EquasysIT/ElectronULA/Kicad/README.md

The Core Carrier board is a board which requires the "EEpizza" board to be fitted. This is a board which actually contains the FPGA.
The MAX 10 Board is a complete board with everything required to replace the Acorn Electron ULA on a single board.

V1.05 is the latest board design including a Micro SD Card socket and enables the use of MMFS for people without the extra Plus 1 hardware.
Ensure the DIP switches are set correctly if connecting a Plus 1
