EquasysIT/ElectronULA/(threads)

Thread 2 (2023-03-30):

Unreliability

EquasysIT, 2023-03-30:
I came across issues when testing the board in an issue 2 Electron. This manifested itself as crashing and general unreliable behaviour. I first thought this was down to noise on the IRQ line which was causing the unwanted interrupts. After much digging into this it transpired that it was NMI interrupts that were occurring due to me forgetting to include a pull up resistor for the NMI pin which was floating. After adding a pull-up resistor this massively improved things although some unreliability was still present. The fix for this was to clock the flash memory which is being used for ROM at 96mhz.

EquasysIT, 2023-05-09:
A further level of unreliable behavior was found to occur with MMFS file access and more specifically JAVA mode 7. MMFS would occasionally fail to access the SD card reliably especially when switching the external 6502 for a different version. Also JAVA mode 7 would keep blanking out especially if the cpu clk timing was altered slightly which shouldn't have caused this effect. After many many hours of testing and working on this issue it was found to be noise transferring from the ROM_n signal which feeds the external ROM. The solution was to drive ROM_n direct from the FPGA and not via the 74HCT125 buffer which has very fast edges. This reduced the noise and all the problems went away !!
