EquasysIT/ElectronULA/Kicad/ElectronULA - MAX 10 Board V1.05/ElectronULA.kicad_pcb

## KiCad design Kicad/ElectronULA - MAX 10 Board V1.05/ElectronULA.kicad_pcb (2023-07-15)

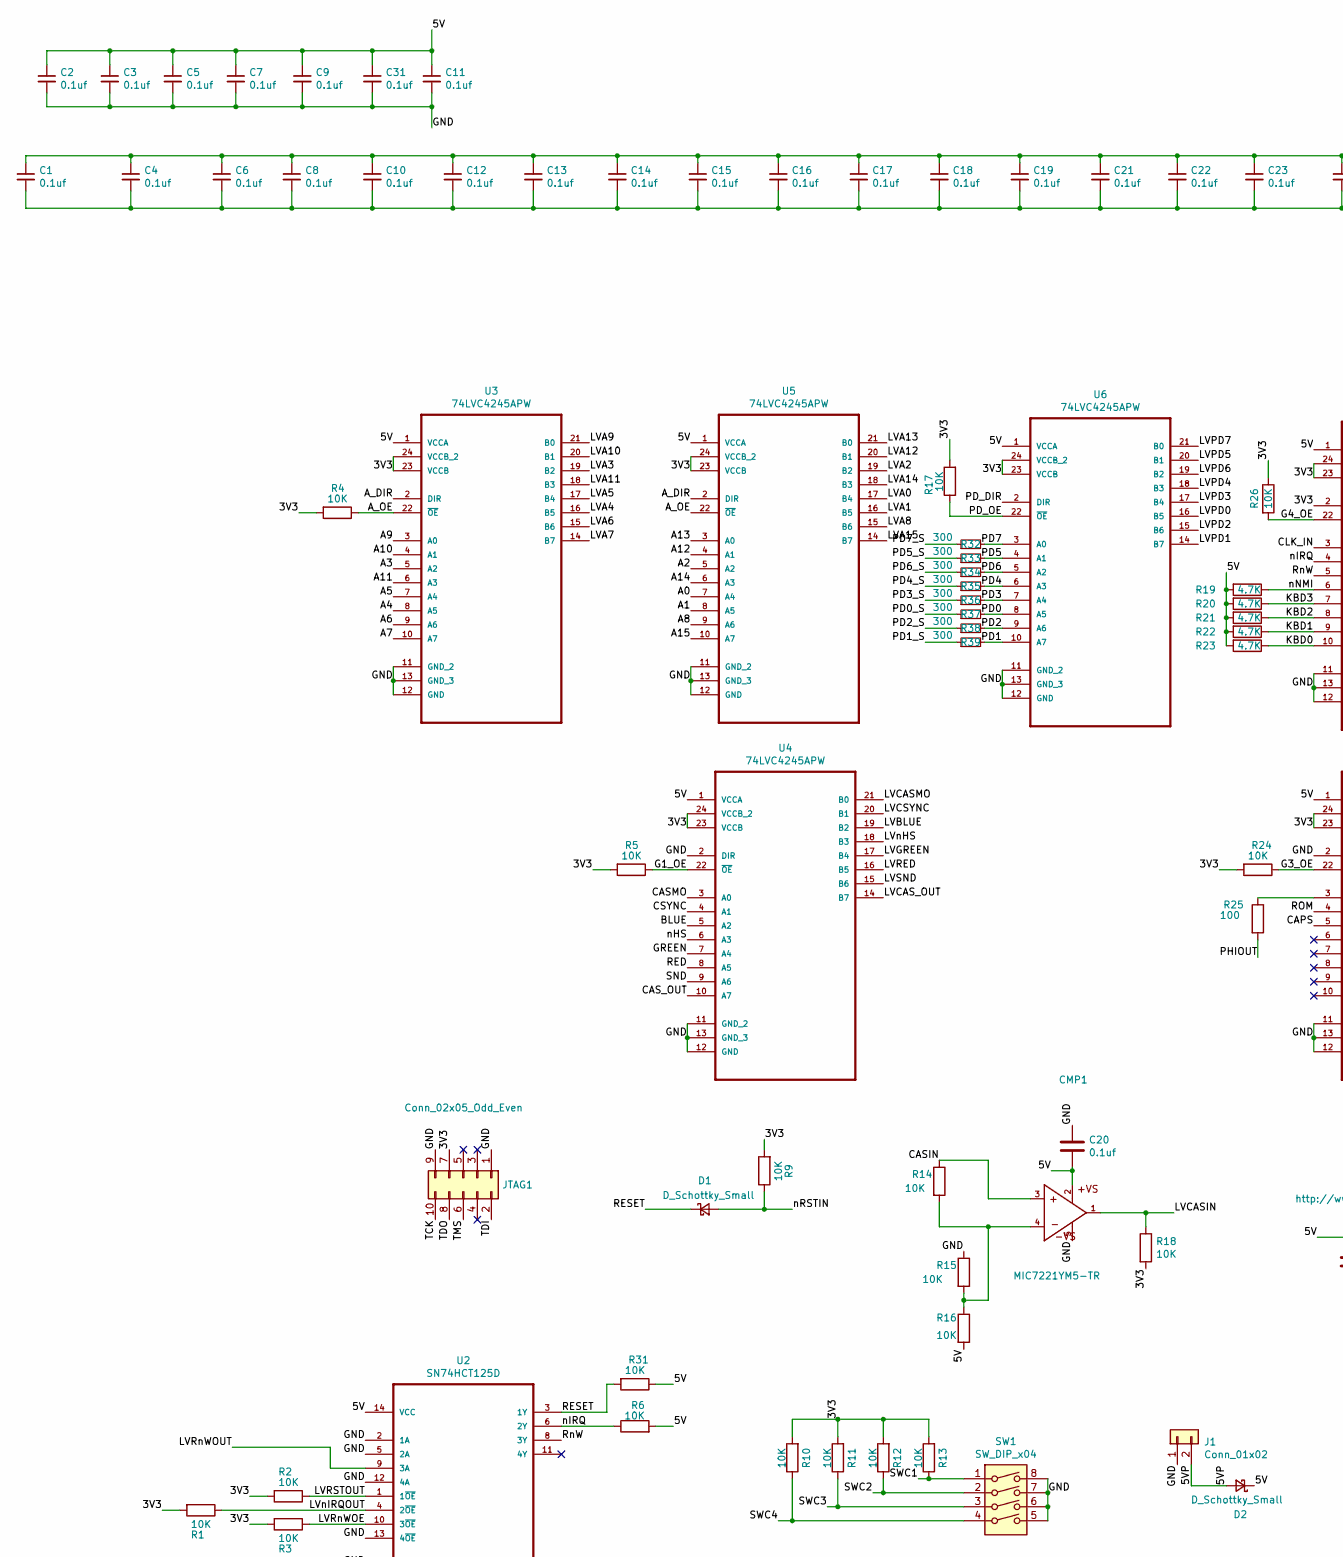
[picture p1: schematic ElectronULA.kicad_sch, part in row 1, column 1]

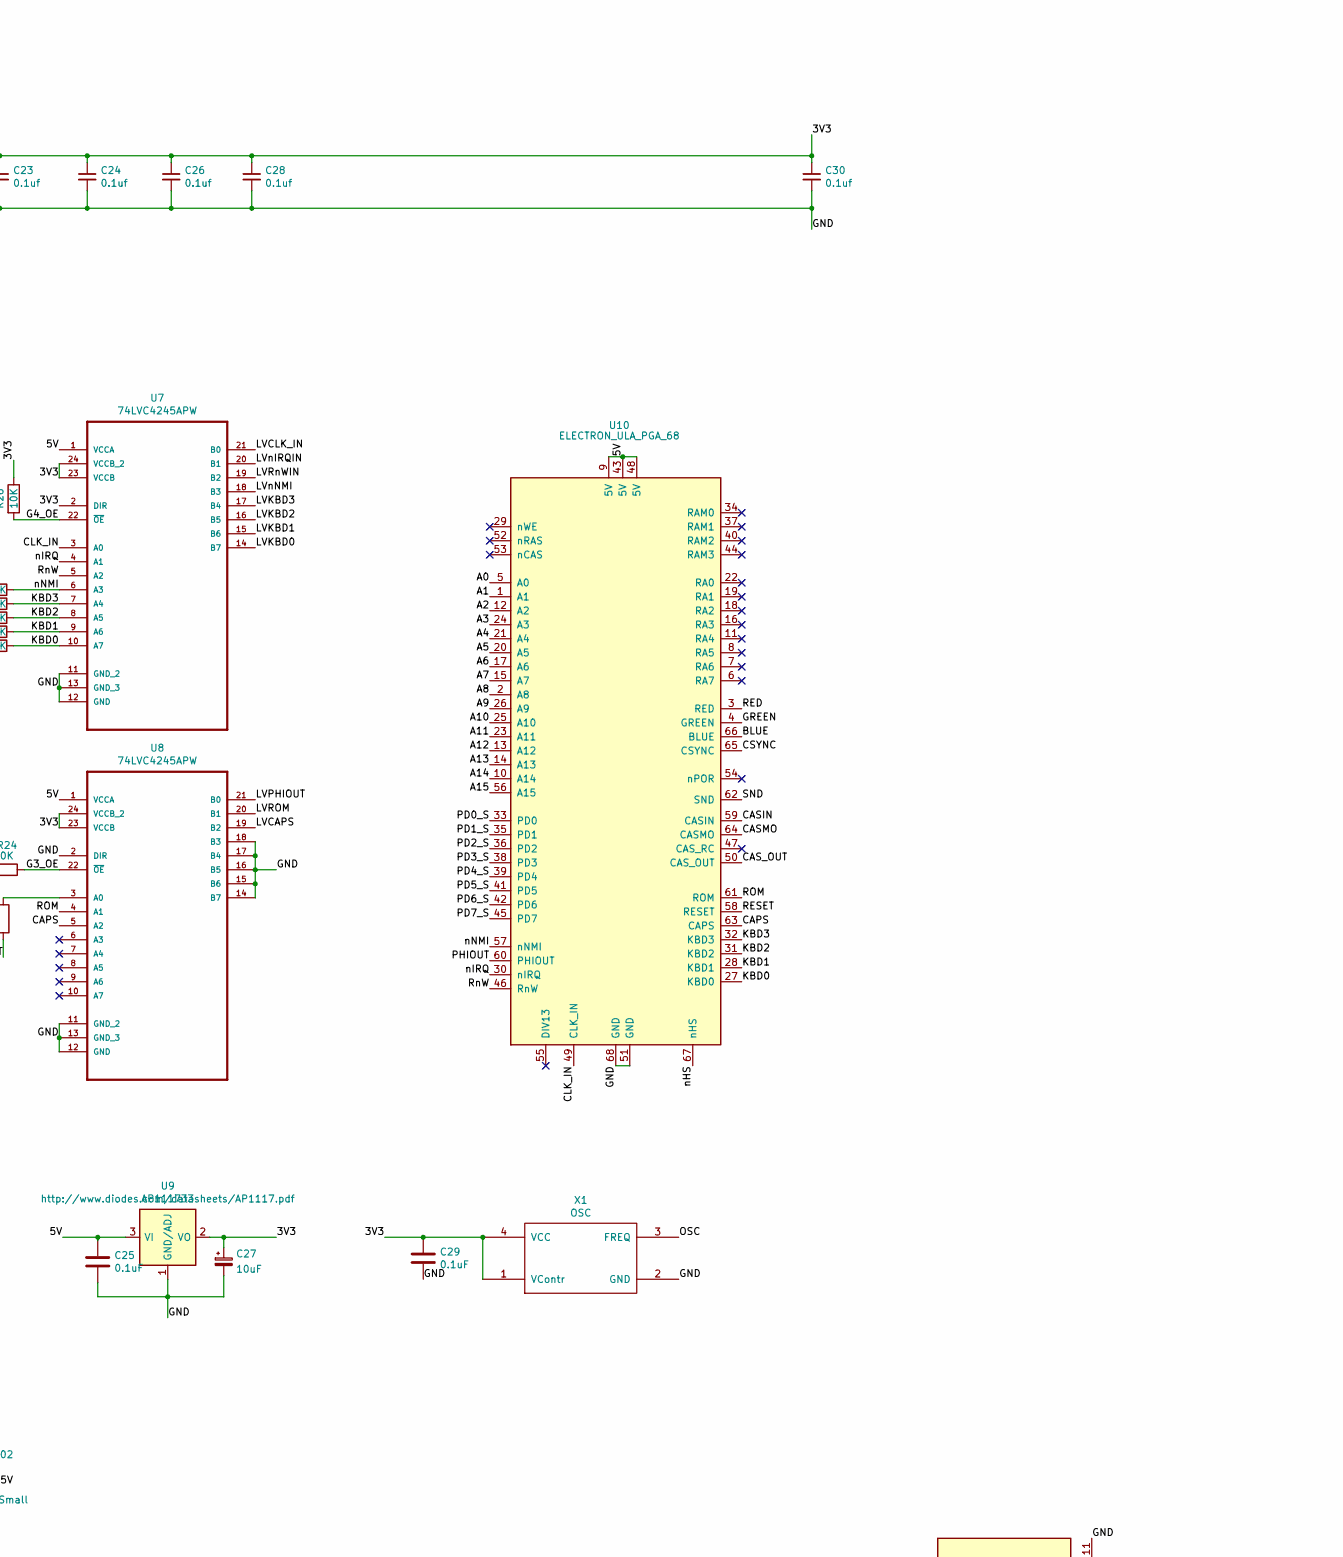
[picture p2: schematic ElectronULA.kicad_sch, part in row 1, column 2]

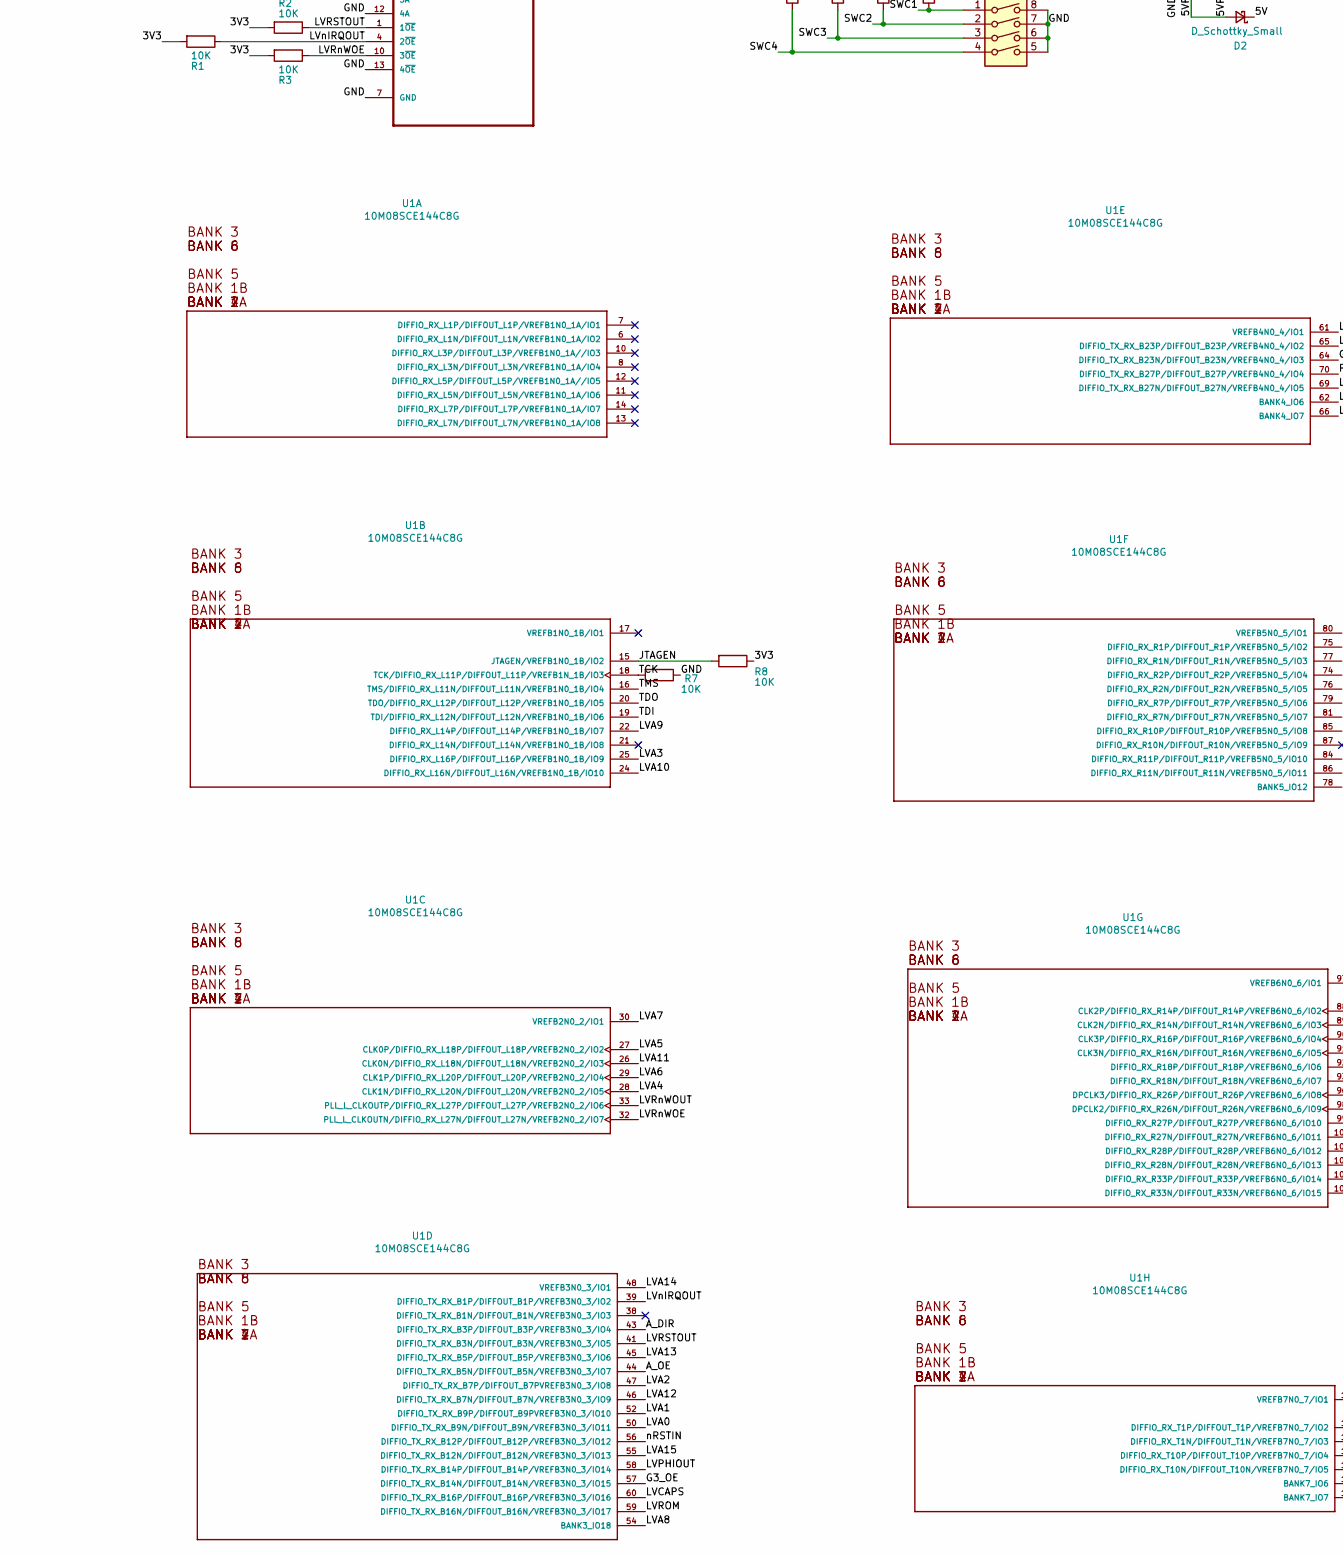
[picture p3: schematic ElectronULA.kicad_sch, part in row 2, column 1]

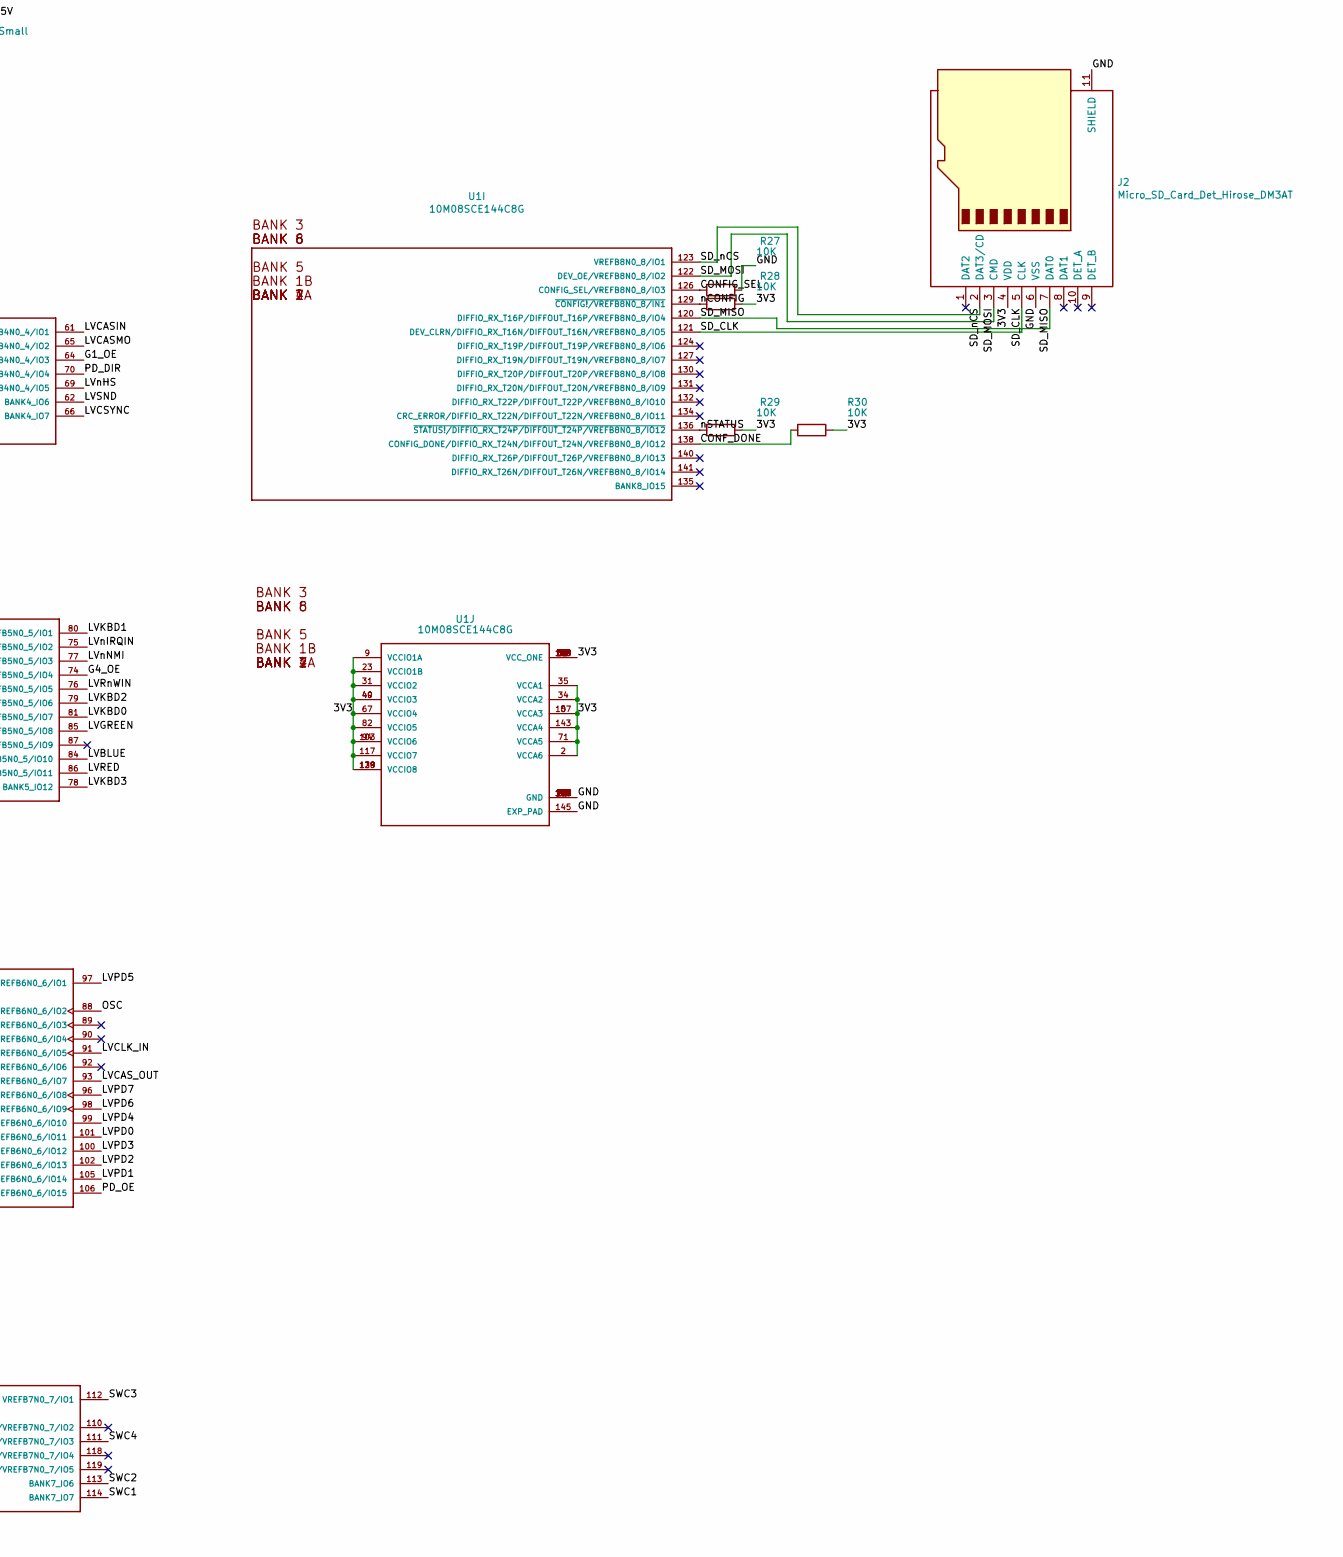
[picture p4: schematic ElectronULA.kicad_sch, part in row 2, column 2]

Parts:
C1, C2, C3, C4, C5, C6, C7, C8, C9, C10, C11, C12, C13, C14, C15, C16, C17, C18, C19, C21, C22, C23, C24, C26, C28, C30, C31: 0.1uf; C_0603_1608Metric_Pad1.08x0.95mm_HandSolder
C20: 0.1uf; C_0805_2012Metric_Pad1.18x1.45mm_HandSolder
C25, C29: 0.1uF; C_0805_2012Metric_Pad1.18x1.45mm_HandSolder
C27: 10uF; C_0805_2012Metric_Pad1.18x1.45mm_HandSolder
CMP1: MIC7221YM5-TR; SOT-23-5
D1, D2: D_Schottky_Small; D_SOD-323_HandSoldering
J1: Conn_01x02; PinHeader_1x02_P2.54mm_Vertical
J2: Micro_SD_Card_Det_Hirose_DM3AT; microSD_HC_Hirose_DM3D-SF
JTAG1: Conn_02x05_Odd_Even; PinHeader_2x05_P2.54mm_Vertical
R1, R2, R3, R4, R5, R6, R7, R8, R10, R11, R12, R13, R17, R24, R26, R27, R28, R29, R30: 10K; R_0603_1608Metric_Pad0.98x0.95mm_HandSolder
R9, R14, R15, R16, R18, R31: 10K; R_0805_2012Metric_Pad1.20x1.40mm_HandSolder
R19: 4.7K; R_0805_2012Metric_Pad1.20x1.40mm_HandSolder
R20, R21, R22, R23: 4.7K; R_0603_1608Metric_Pad0.98x0.95mm_HandSolder
R25: 100; R_0805_2012Metric_Pad1.20x1.40mm_HandSolder
R32, R33, R34, R35, R36, R37, R38, R39: 300; R_0603_1608Metric_Pad0.98x0.95mm_HandSolder
SW1: SW_DIP_x04; SW_DIP_SPSTx04_Slide_Copal_CHS-04B_W7.62mm_P1.27mm
U1: 10M08SCE144C8G; QFP50P2200X2200X165-145N
U2: SN74HCT125D; TSSOP-14_4.4x5mm_P0.65mm
U3, U4, U5, U6, U7, U8: 74LVC4245APW; TSSOP-24_4.4x7.8mm_P0.65mm
U9: AP111733; SOT-223
U10: ELECTRON_ULA_PGA_68; PLCC-68_THT-Socket-Electron-ULA
X1: OSC; Crystal_SMD_7050_4Pads

Connections:
/3V3: C1.1, C4.1, C6.1, C8.1, C10.1, C12.1, C13.1, C14.1, C15.1, C16.1, C17.1, C18.1, C19.1, C21.1, C22.1, C23.1, C24.1, C26.1, C27.1, C28.1, C29.1, C30.1, J2.4 (VDD), JTAG1.7, R1.2, R2.2, R3.2, R4.2, R5.2, R8.1, R9.2, R10.2, R11.2, R12.2, R13.2, R17.2, R18.2, R24.2, R26.1, R28.1, R29.1, R30.1, U1.1 (VCC_ONE), U1.2 (VCCA6), U1.5 (VCCA3), U1.9 (VCCIO1A), U1.23 (VCCIO1B), U1.31 (VCCIO2), U1.34 (VCCA2), U1.35 (VCCA1), U1.36 (VCC_ONE), U1.37 (VCC_ONE), U1.40 (VCCIO3), U1.49 (VCCIO3), U1.51 (VCC_ONE), U1.67 (VCCIO4), U1.71 (VCCA5), U1.72 (VCC_ONE), U1.73 (VCC_ONE), U1.82 (VCCIO5), U1.94 (VCCIO6), U1.103 (VCCIO6), U1.107 (VCCA3), U1.108 (VCC_ONE), U1.109 (VCC_ONE), U1.115 (VCC_ONE), U1.117 (VCCIO7), U1.128 (VCCIO8), U1.139 (VCCIO8), U1.143 (VCCA4), U1.144 (VCC_ONE), U3.23 (VCCB), U3.24 (VCCB_2), U4.23 (VCCB), U4.24 (VCCB_2), U5.23 (VCCB), U5.24 (VCCB_2), U6.23 (VCCB), U6.24 (VCCB_2), U7.2 (DIR), U7.23 (VCCB), U7.24 (VCCB_2), U8.23 (VCCB), U8.24 (VCCB_2), U9.2 (VO), X1.1 (VContr), X1.4 (VCC)
/5V: C2.1, C3.1, C5.1, C7.1, C9.1, C11.1, C20.2, C25.1, C31.1, CMP1.2 (+VS), D2.1 (K), R6.2, R16.2, R19.2, R20.2, R21.2, R22.2, R23.2, R31.1, U2.14 (VCC), U3.1 (VCCA), U4.1 (VCCA), U5.1 (VCCA), U6.1 (VCCA), U7.1 (VCCA), U8.1 (VCCA), U9.3 (VI), U10.9 (5V), U10.43 (5V), U10.48 (5V)
/5VP: D2.2 (A), J1.2
/A0: U5.7 (A4), U10.5 (A0)
/A1: U5.8 (A5), U10.1 (A1)
/A2: U5.5 (A2), U10.12 (A2)
/A3: U3.5 (A2), U10.24 (A3)
/A4: U3.8 (A5), U10.21 (A4)
/A5: U3.7 (A4), U10.20 (A5)
/A6: U3.9 (A6), U10.17 (A6)
/A7: U3.10 (A7), U10.15 (A7)
/A8: U5.9 (A6), U10.2 (A8)
/A9: U3.3 (A0), U10.26 (A9)
/A10: U3.4 (A1), U10.25 (A10)
/A11: U3.6 (A3), U10.23 (A11)
/A12: U5.4 (A1), U10.13 (A12)
/A13: U5.3 (A0), U10.14 (A13)
/A14: U5.6 (A3), U10.10 (A14)
/A15: U5.10 (A7), U10.56 (A15)
/A_DIR: U1.43 (DIFFIO_TX_RX_B3P/DIFFOUT_B3P/VREFB3N0_3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), U3.2 (DIR), U5.2 (DIR)
/A_OE: R4.1, U1.44 (DIFFIO_TX_RX_B5N/DIFFOUT_B5N/VREFB3N0_3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), U3.22 (~OE), U5.22 (~OE)
/BLUE: U4.5 (A2), U10.66 (BLUE)
/CAPS: U8.5 (A2), U10.63 (CAPS)
/CASIN: CMP1.3 (IN+), R14.1, U10.59 (CASIN)
/CASMO: U4.3 (A0), U10.64 (CASMO)
/CAS_OUT: U4.10 (A7), U10.50 (CAS_OUT)
/CLK_IN: U7.3 (A0), U10.49 (CLK_IN)
/CONFIG_SEL: R27.2, U1.126 (CONFIG_SEL/VREFB8N0_8/IO3)
/CONF_DONE: R30.2, U1.138 (CONFIG_DONE/DIFFIO_RX_T24N/DIFFOUT_T24N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)
/CSYNC: U4.4 (A1), U10.65 (CSYNC)
/G1_OE: R5.1, U1.64 (DIFFIO_TX_RX_B23N/DIFFOUT_B23N/VREFB4N0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), U4.22 (~OE)
/G3_OE: R24.1, U1.57 (DIFFIO_TX_RX_B14N/DIFFOUT_B14N/VREFB3N0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), U8.22 (~OE)
/G4_OE: R26.2, U1.74 (DIFFIO_RX_R2P/DIFFOUT_R2P/VREFB5N0_5/IO4), U7.22 (~OE)
/GND: C1.2, C2.2, C3.2, C4.2, C5.2, C6.2, C7.2, C8.2, C9.2, C10.2, C11.2, C12.2, C13.2, C14.2, C15.2, C16.2, C17.2, C18.2, C19.2, C20.1, C21.2, C22.2, C23.2, C24.2, C25.2, C26.2, C27.2, C28.2, C29.2, C30.2, C31.2, CMP1.5 (-VS), J1.1, J2.6 (VSS), J2.11 (SHIELD), JTAG1.1, JTAG1.9, R7.1, R15.1, R27.1, SW1.5, SW1.6, SW1.7, SW1.8, U1.3 (GND), U1.4 (GND), U1.42 (GND), U1.53 (GND), U1.63 (GND), U1.68 (GND), U1.83 (GND), U1.95 (GND), U1.104 (GND), U1.116 (GND), U1.125 (GND), U1.133 (GND), U1.137 (GND), U1.142 (GND), U1.145 (EXP_PAD), U2.2 (1A), U2.5 (2A), U2.7 (GND), U2.12 (4A), U2.13 (4~OE), U3.11 (GND_2), U3.12 (GND), U3.13 (GND_3), U4.2 (DIR), U4.11 (GND_2), U4.12 (GND), U4.13 (GND_3), U5.11 (GND_2), U5.12 (GND), U5.13 (GND_3), U6.11 (GND_2), U6.12 (GND), U6.13 (GND_3), U7.11 (GND_2), U7.12 (GND), U7.13 (GND_3), U8.2 (DIR), U8.11 (GND_2), U8.12 (GND), U8.13 (GND_3), U8.14 (B7), U8.15 (B6), U8.16 (B5), U8.17 (B4), U8.18 (B3), U9.1 (GND/ADJ), U10.51 (GND), U10.68 (GND), X1.2 (GND); also elsewhere on the board
/GREEN: U4.7 (A4), U10.4 (GREEN)
/JTAGEN: R8.2, U1.15 (JTAGEN/VREFB1N0_1B/IO2)
/KBD0: R23.1, U7.10 (A7), U10.27 (KBD0)
/KBD1: R22.1, U7.9 (A6), U10.28 (KBD1)
/KBD2: R21.1, U7.8 (A5), U10.31 (KBD2)
/KBD3: R20.1, U7.7 (A4), U10.32 (KBD3)
/LVA0: U1.50 (DIFFIO_TX_RX_B9N/DIFFOUT_B9N/VREFB3N0_3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), U5.17 (B4)
/LVA1: U1.52 (DIFFIO_TX_RX_B9P/DIFFOUT_B9PVREFB3N0_3/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), U5.16 (B5)
/LVA2: U1.47 (DIFFIO_TX_RX_B7P/DIFFOUT_B7PVREFB3N0_3/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), U5.19 (B2)
/LVA3: U1.25 (DIFFIO_RX_L16P/DIFFOUT_L16P/VREFB1N0_1B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), U3.19 (B2)
/LVA4: U1.28 (CLK1N/DIFFIO_RX_L20N/DIFFOUT_L20N/VREFB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), U3.16 (B5)
/LVA5: U1.27 (CLK0P/DIFFIO_RX_L18P/DIFFOUT_L18P/VREFB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), U3.17 (B4)
/LVA6: U1.29 (CLK1P/DIFFIO_RX_L20P/DIFFOUT_L20P/VREFB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), U3.15 (B6)
/LVA7: U1.30 (VREFB2N0_2/IO1), U3.14 (B7)
/LVA8: U1.54 (BANK3_IO18), U5.15 (B6)
/LVA9: U1.22 (DIFFIO_RX_L14P/DIFFOUT_L14P/VREFB1N0_1B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), U3.21 (B0)
/LVA10: U1.24 (DIFFIO_RX_L16N/DIFFOUT_L16N/VREFB1N0_1B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), U3.20 (B1)
/LVA11: U1.26 (CLK0N/DIFFIO_RX_L18N/DIFFOUT_L18N/VREFB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), U3.18 (B3)
/LVA12: U1.46 (DIFFIO_TX_RX_B7N/DIFFOUT_B7N/VREFB3N0_3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), U5.20 (B1)
/LVA13: U1.45 (DIFFIO_TX_RX_B5P/DIFFOUT_B5P/VREFB3N0_3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), U5.21 (B0)
/LVA14: U1.48 (VREFB3N0_3/IO1), U5.18 (B3)
/LVA15: U1.55 (DIFFIO_TX_RX_B12N/DIFFOUT_B12N/VREFB3N0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), U5.14 (B7)
/LVBLUE: U1.84 (DIFFIO_RX_R11P/DIFFOUT_R11P/VREFB5N0_5/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), U4.19 (B2)
/LVCAPS: U1.60 (DIFFIO_TX_RX_B16P/DIFFOUT_B16P/VREFB3N0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), U8.19 (B2)
/LVCASIN: CMP1.1 (OUT), R18.1, U1.61 (VREFB4N0_4/IO1)
/LVCASMO: U1.65 (DIFFIO_TX_RX_B23P/DIFFOUT_B23P/VREFB4N0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), U4.21 (B0)
/LVCAS_OUT: U1.93 (DIFFIO_RX_R18N/DIFFOUT_R18N/VREFB6N0_6/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), U4.14 (B7)
/LVCLK_IN: U1.91 (CLK3N/DIFFIO_RX_R16N/DIFFOUT_R16N/VREFB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), U7.21 (B0)
/LVCSYNC: U1.66 (BANK4_IO7), U4.20 (B1)
/LVGREEN: U1.85 (DIFFIO_RX_R10P/DIFFOUT_R10P/VREFB5N0_5/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), U4.17 (B4)
/LVKBD0: U1.81 (DIFFIO_RX_R7N/DIFFOUT_R7N/VREFB5N0_5/IO7), U7.14 (B7)
/LVKBD1: U1.80 (VREFB5N0_5/IO1), U7.15 (B6)
/LVKBD2: U1.79 (DIFFIO_RX_R7P/DIFFOUT_R7P/VREFB5N0_5/IO6), U7.16 (B5)
/LVKBD3: U1.78 (BANK5_IO12), U7.17 (B4)
/LVPD0: U1.101 (DIFFIO_RX_R27N/DIFFOUT_R27N/VREFB6N0_6/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), U6.16 (B5)
/LVPD1: U1.105 (DIFFIO_RX_R33P/DIFFOUT_R33P/VREFB6N0_6/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), U6.14 (B7)
/LVPD2: U1.102 (DIFFIO_RX_R28N/DIFFOUT_R28N/VREFB6N0_6/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), U6.15 (B6)
/LVPD3: U1.100 (DIFFIO_RX_R28P/DIFFOUT_R28P/VREFB6N0_6/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), U6.17 (B4)
/LVPD4: U1.99 (DIFFIO_RX_R27P/DIFFOUT_R27P/VREFB6N0_6/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), U6.18 (B3)
/LVPD5: U1.97 (VREFB6N0_6/IO1), U6.20 (B1)
/LVPD6: U1.98 (DPCLK2/DIFFIO_RX_R26N/DIFFOUT_R26N/VREF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), U6.19 (B2)
/LVPD7: U1.96 (DPCLK3/DIFFIO_RX_R26P/DIFFOUT_R26P/VREF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), U6.21 (B0)
/LVPHIOUT: U1.58 (DIFFIO_TX_RX_B14P/DIFFOUT_B14P/VREFB3N0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), U8.21 (B0)
/LVRED: U1.86 (DIFFIO_RX_R11N/DIFFOUT_R11N/VREFB5N0_5/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), U4.16 (B5)
/LVROM: U1.59 (DIFFIO_TX_RX_B16N/DIFFOUT_B16N/VREFB3N0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), U8.20 (B1)
/LVRSTOUT: R2.1, U1.41 (DIFFIO_TX_RX_B3N/DIFFOUT_B3N/VREFB3N0_3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), U2.1 (1~OE)
/LVRnWIN: U1.76 (DIFFIO_RX_R2N/DIFFOUT_R2N/VREFB5N0_5/IO5), U7.19 (B2)
/LVRnWOE: R3.1, U1.32 (PLL_L_CLKOUTN/DIFFIO_RX_L27N/DIFFOUT_L2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), U2.10 (3~OE)
/LVRnWOUT: U1.33 (PLL_L_CLKOUTP/DIFFIO_RX_L27P/DIFFOUT_L2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), U2.9 (3A)
/LVSND: U1.62 (BANK4_IO6), U4.15 (B6)
/LVnHS: U1.69 (DIFFIO_TX_RX_B27N/DIFFOUT_B27N/VREFB4N0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), U4.18 (B3)
/LVnIRQIN: U1.75 (DIFFIO_RX_R1P/DIFFOUT_R1P/VREFB5N0_5/IO2), U7.20 (B1)
/LVnIRQOUT: R1.1, U1.39 (DIFFIO_TX_RX_B1P/DIFFOUT_B1P/VREFB3N0_3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), U2.4 (2~OE)
/LVnNMI: U1.77 (DIFFIO_RX_R1N/DIFFOUT_R1N/VREFB5N0_5/IO3), U7.18 (B3)
/OSC: U1.88 (CLK2P/DIFFIO_RX_R14P/DIFFOUT_R14P/VREFB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), X1.3 (FREQ)
/PD0: R37.2, U6.8 (A5)
/PD0_S: R37.1, U10.33 (PD0)
/PD1: R39.2, U6.10 (A7)
/PD1_S: R39.1, U10.35 (PD1)
/PD2: R38.2, U6.9 (A6)
/PD2_S: R38.1, U10.36 (PD2)
/PD3: R36.2, U6.7 (A4)
/PD3_S: R36.1, U10.38 (PD3)
/PD4: R35.2, U6.6 (A3)
/PD4_S: R35.1, U10.39 (PD4)
/PD5: R33.2, U6.4 (A1)
/PD5_S: R33.1, U10.41 (PD5)
/PD6: R34.2, U6.5 (A2)
/PD6_S: R34.1, U10.42 (PD6)
/PD7: R32.2, U6.3 (A0)
/PD7_S: R32.1, U10.45 (PD7)
/PD_DIR: U1.70 (DIFFIO_TX_RX_B27P/DIFFOUT_B27P/VREFB4N0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), U6.2 (DIR)
/PD_OE: R17.1, U1.106 (DIFFIO_RX_R33N/DIFFOUT_R33N/VREFB6N0_6/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), U6.22 (~OE)
/PHIOUT: R25.2, U10.60 (PHIOUT)
/RED: U4.8 (A5), U10.3 (RED)
/RESET: D1.1 (K), R31.2, U2.3 (1Y), U10.58 (RESET)
/ROM: U8.4 (A1), U10.61 (ROM)
/RnW: U2.8 (3Y), U7.5 (A2), U10.46 (RnW)
/SD_CLK: J2.5 (CLK), U1.121 (DEV_CLRN/DIFFIO_RX_T16N/DIFFOUT_T16N/VR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)
/SD_MISO: J2.7 (DAT0), U1.120 (DIFFIO_RX_T16P/DIFFOUT_T16P/VREFB8N0_8/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)
/SD_MOSI: J2.3 (CMD), U1.122 (DEV_OE/VREFB8N0_8/IO2)
/SD_nCS: J2.2 (DAT3/CD), U1.123 (VREFB8N0_8/IO1)
/SND: U4.9 (A6), U10.62 (SND)
/SWC1: R13.1, SW1.1, U1.114 (BANK7_IO7)
/SWC2: R12.1, SW1.2, U1.113 (BANK7_IO6)
/SWC3: R11.1, SW1.3, U1.112 (VREFB7N0_7/IO1)
/SWC4: R10.1, SW1.4, U1.111 (DIFFIO_RX_T1N/DIFFOUT_T1N/VREFB7N0_7/IO3)
/TCK: JTAG1.10, R7.2, U1.18 (TCK/DIFFIO_RX_L11P/DIFFOUT_L11P/VREFB1N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)
/TDI: JTAG1.2, U1.19 (TDI/DIFFIO_RX_L12N/DIFFOUT_L12N/VREFB1N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)
/TDO: JTAG1.8, U1.20 (TDO/DIFFIO_RX_L12P/DIFFOUT_L12P/VREFB1N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)
/TMS: JTAG1.6, U1.16 (TMS/DIFFIO_RX_L11N/DIFFOUT_L11N/VREFB1N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)
/nCONFIG: R28.2, U1.129 (~CONFIG!/VREFB8N0_8/IN1)
/nHS: U4.6 (A3), U10.67 (nHS)
/nIRQ: R6.1, U2.6 (2Y), U7.4 (A1), U10.30 (nIRQ)
/nNMI: R19.1, U7.6 (A3), U10.57 (nNMI)
/nRSTIN: D1.2 (A), R9.1, U1.56 (DIFFIO_TX_RX_B12P/DIFFOUT_B12P/VREFB3N0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)
/nSTATUS: R29.2, U1.136 (~STATUS!/DIFFIO_RX_T24P/DIFFOUT_T24P/VR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)
unnamed: CMP1.4 (IN-), R14.2, R15.2, R16.1
unnamed: R25.1, U8.3 (A0)

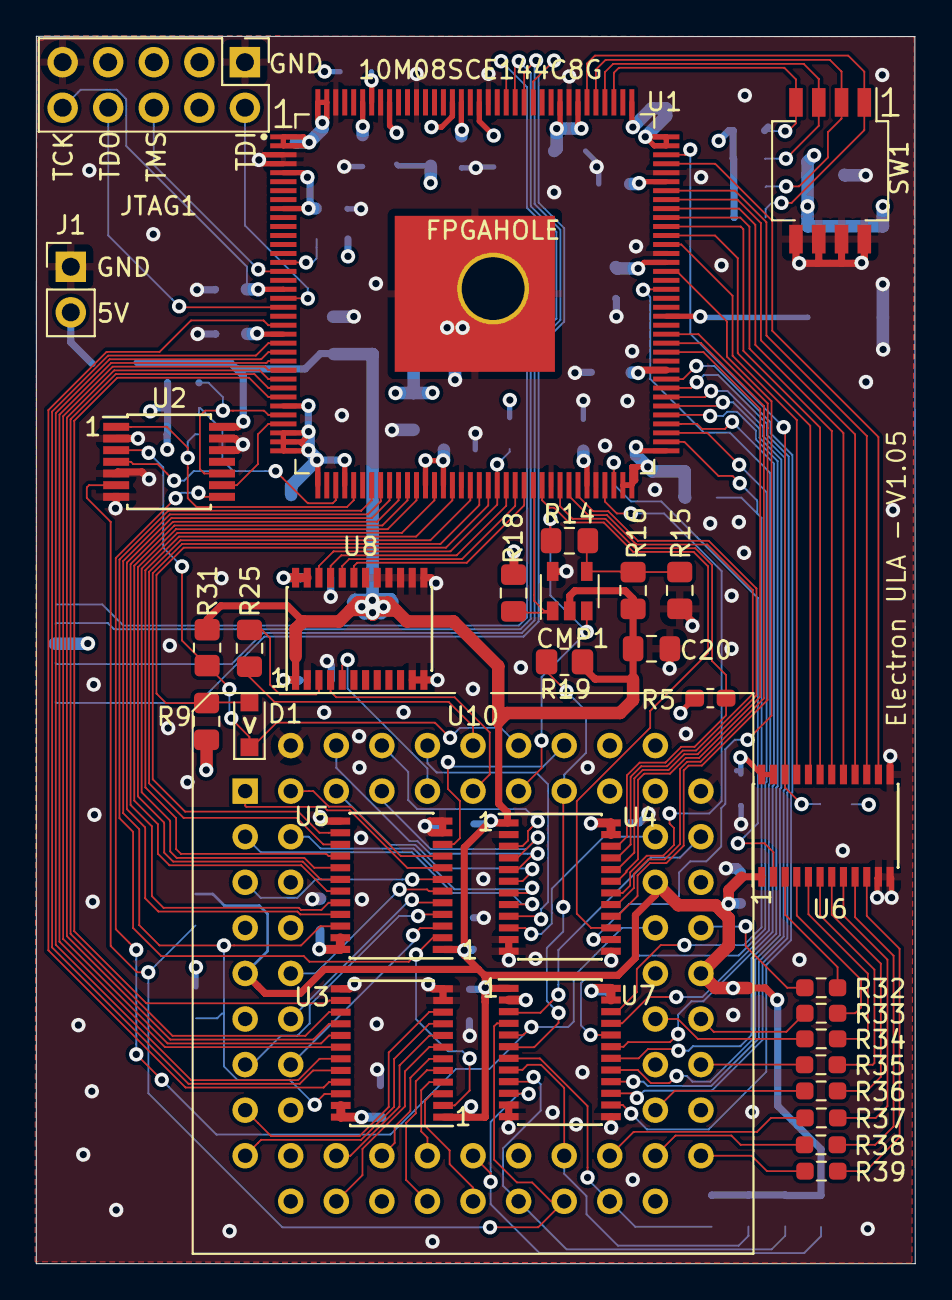
[picture p5: board Kicad/ElectronULA - MAX 10 Board V1.05/ElectronULA.kicad_pcb from above]

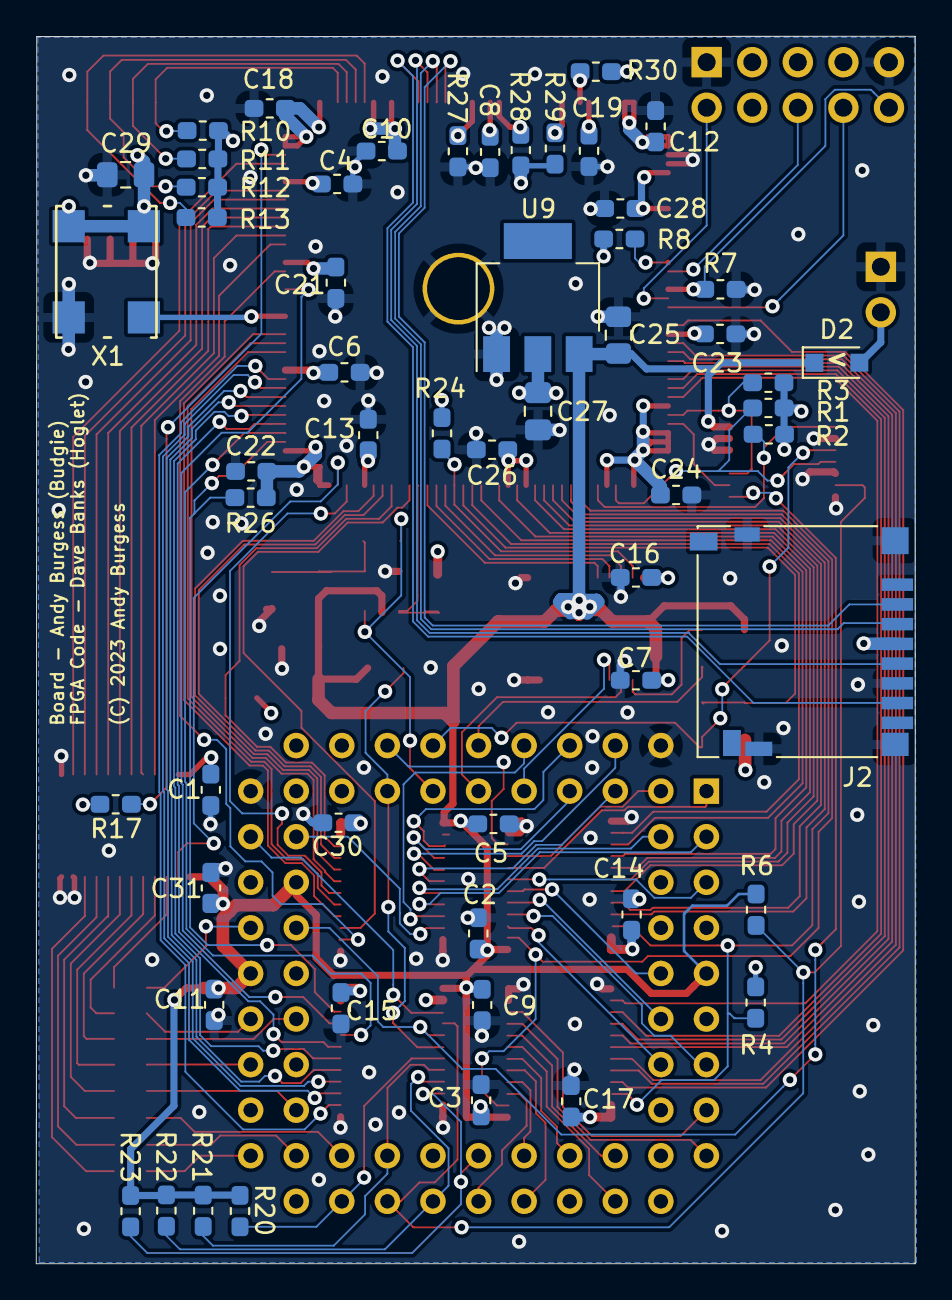
[picture p6: board Kicad/ElectronULA - MAX 10 Board V1.05/ElectronULA.kicad_pcb from below]

Board: 4 copper layers, 49.0 x 68.4 mm, 89 parts (56 on the bottom side), 133 nets.

Other parts of the board:
FPGAHOLE: MountingHole_2.7mm_M2.5_ISO7380_Pad

Their connections:
/GND: FPGAHOLE.1; also elsewhere on the board
