EquasysIT/ElectronULA/Kicad/ElectronULA - Core Carrier Board/ElectronULA.kicad_pcb

## KiCad design Kicad/ElectronULA - Core Carrier Board/ElectronULA.kicad_pcb (2020-05-04)

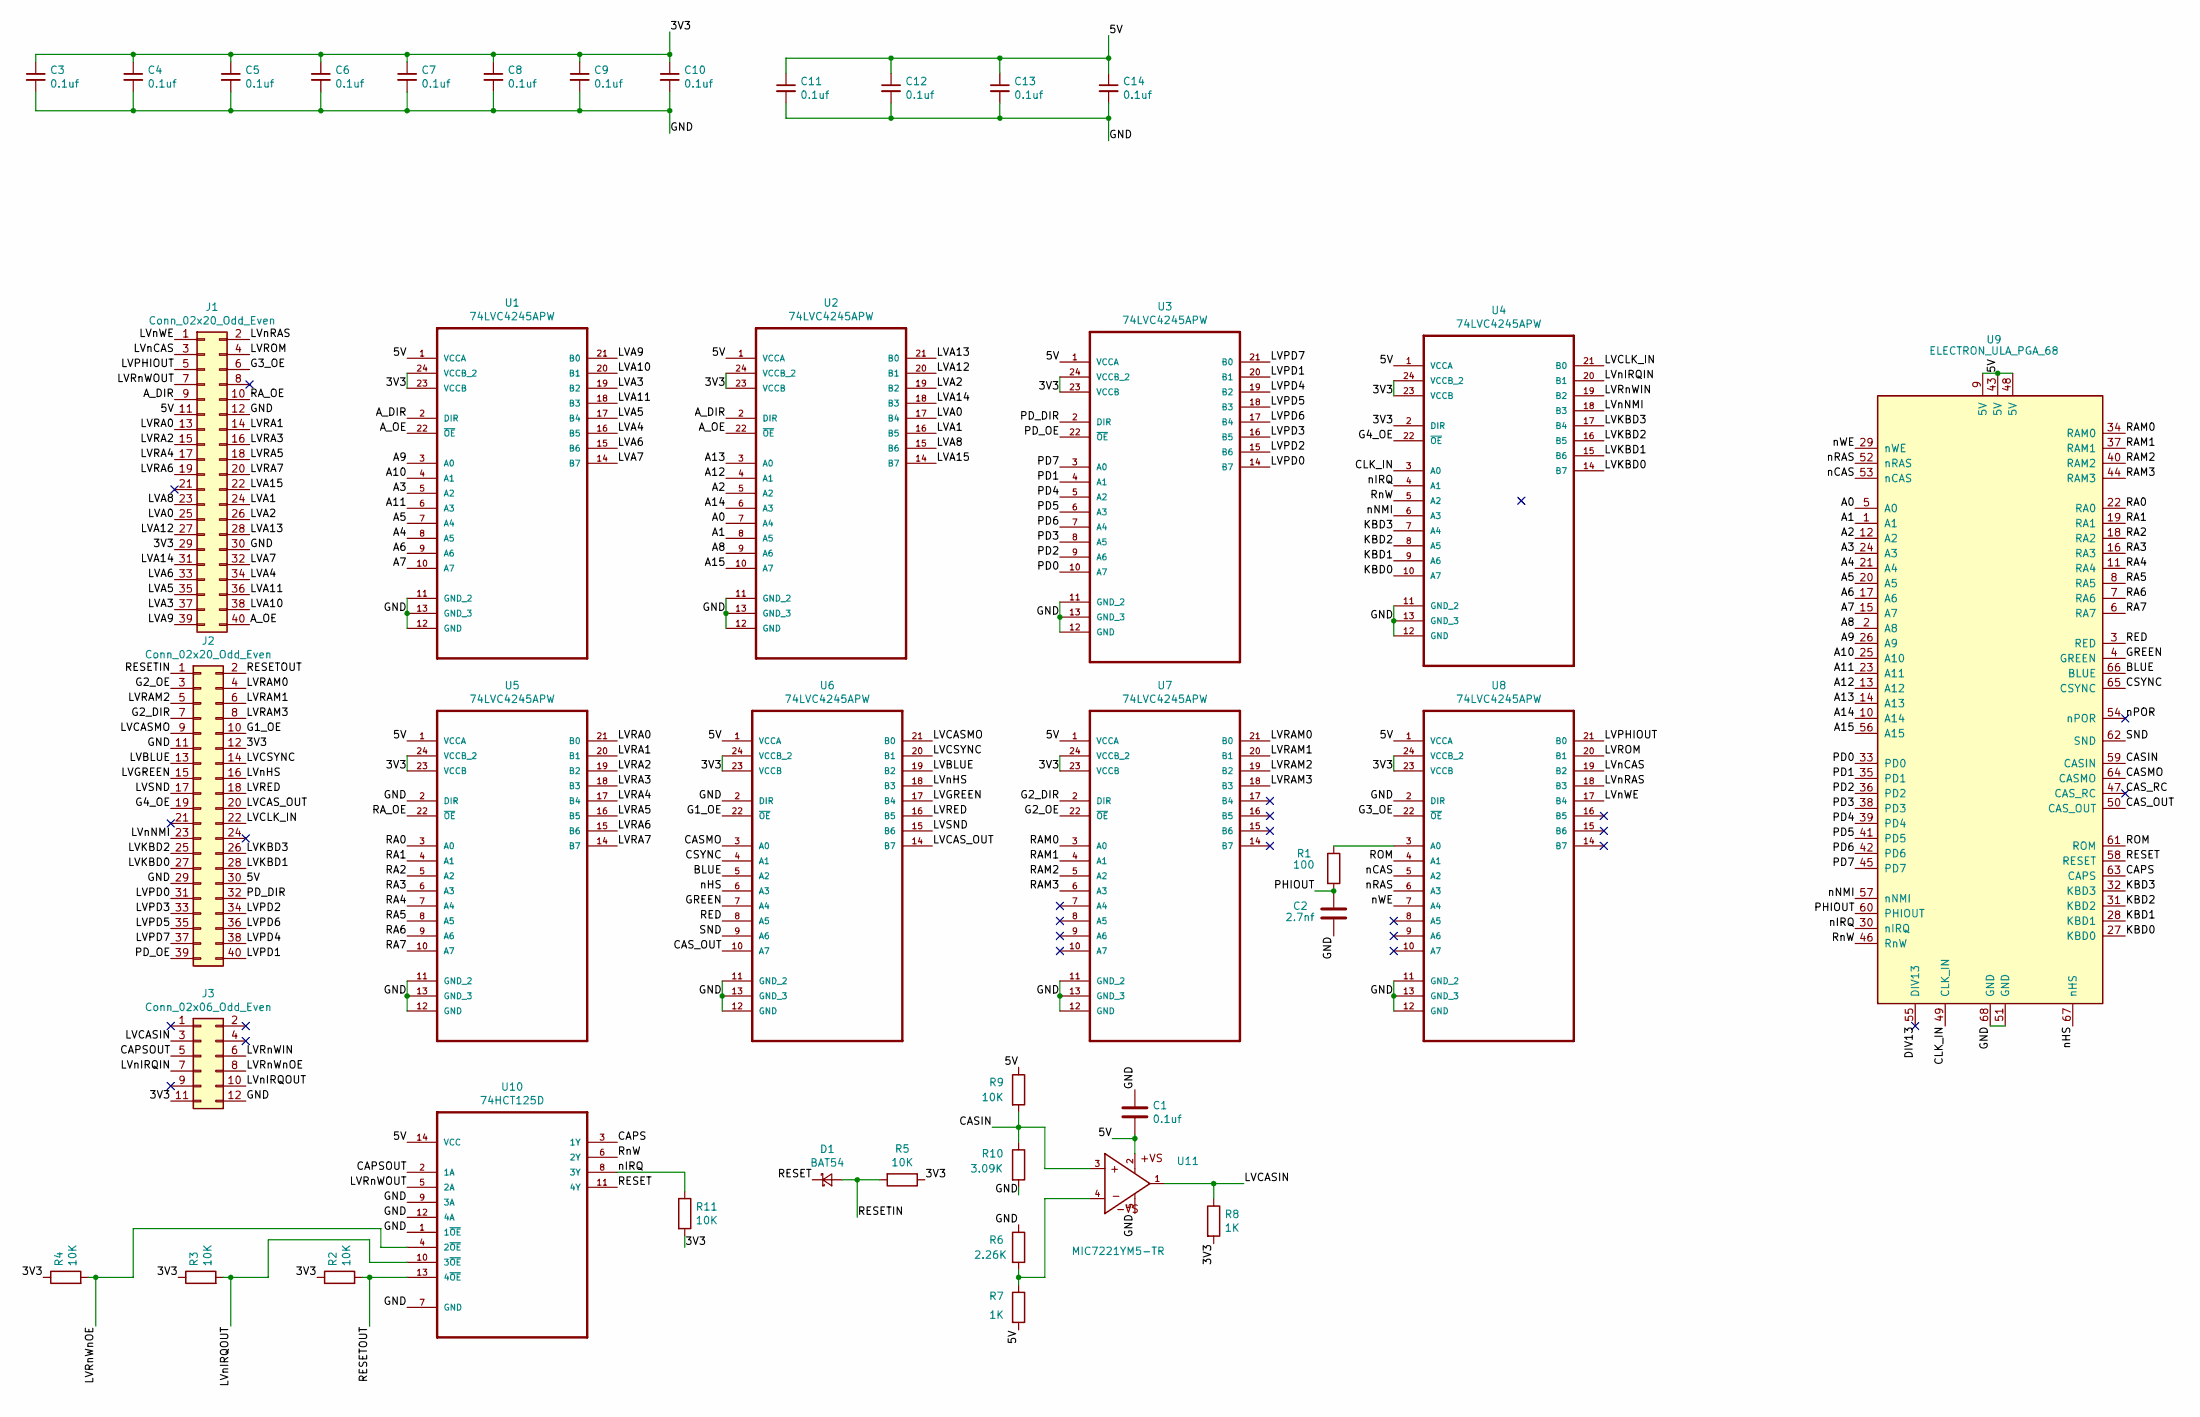
[picture p7: schematic ElectronULA.sch]

Parts:
C1: 0.1uf; C_0805_2012Metric_Pad1.15x1.40mm_HandSolder
C2: 2.7nf; C_0805_2012Metric_Pad1.15x1.40mm_HandSolder
C3, C4, C5, C6, C7, C8, C9, C10, C11, C12, C13, C14: 0.1uf; C_0603_1608Metric_Pad1.05x0.95mm_HandSolder
D1: BAT54; D_SOD-323_HandSoldering
J1, J2: Conn_02x20_Odd_Even; PinSocket_2x20_P2.54mm_Vertical
J3: Conn_02x06_Odd_Even; PinSocket_2x06_P2.54mm_Vertical
R1: 100; R_0805_2012Metric_Pad1.15x1.40mm_HandSolder
R2, R3, R4, R5, R9, R11: 10K; R_0805_2012Metric_Pad1.15x1.40mm_HandSolder
R6: 2.26K; R_0805_2012Metric_Pad1.15x1.40mm_HandSolder
R7, R8: 1K; R_0805_2012Metric_Pad1.15x1.40mm_HandSolder
R10: 3.09K; R_0805_2012Metric_Pad1.15x1.40mm_HandSolder
U1, U2, U3, U4, U5, U6, U7, U8: 74LVC4245APW; TSSOP-24_4.4x7.8mm_P0.65mm
U9: ELECTRON_ULA_PGA_68; PLCC-68_THT-Socket-Electron-ULA
U10: 74HCT125D; TSSOP-14_4.4x5mm_P0.65mm
U11: MIC7221YM5-TR; SOT-23-5

Connections:
/3V3: C3.1, C4.1, C5.1, C6.1, C7.1, C8.1, C9.1, C10.1, J1.29, J2.12, J3.11, R2.1, R3.1, R4.1, R5.1, R8.2, R11.2, U1.23 (VCCB), U1.24 (VCCB_2), U2.23 (VCCB), U2.24 (VCCB_2), U3.23 (VCCB), U3.24 (VCCB_2), U4.2 (DIR), U4.23 (VCCB), U4.24 (VCCB_2), U5.23 (VCCB), U5.24 (VCCB_2), U6.23 (VCCB), U6.24 (VCCB_2), U7.23 (VCCB), U7.24 (VCCB_2), U8.23 (VCCB), U8.24 (VCCB_2)
/5V: C1.2, C11.1, C12.1, C13.1, C14.1, J1.11, J2.30, R7.2, R9.1, U1.1 (VCCA), U2.1 (VCCA), U3.1 (VCCA), U4.1 (VCCA), U5.1 (VCCA), U6.1 (VCCA), U7.1 (VCCA), U8.1 (VCCA), U9.9 (5V), U9.43 (5V), U9.48 (5V), U10.14 (VCC), U11.2 (+VS)
/A0: U2.7 (A4), U9.5 (A0)
/A1: U2.8 (A5), U9.1 (A1)
/A2: U2.5 (A2), U9.12 (A2)
/A3: U1.5 (A2), U9.24 (A3)
/A4: U1.8 (A5), U9.21 (A4)
/A5: U1.7 (A4), U9.20 (A5)
/A6: U1.9 (A6), U9.17 (A6)
/A7: U1.10 (A7), U9.15 (A7)
/A8: U2.9 (A6), U9.2 (A8)
/A9: U1.3 (A0), U9.26 (A9)
/A10: U1.4 (A1), U9.25 (A10)
/A11: U1.6 (A3), U9.23 (A11)
/A12: U2.4 (A1), U9.13 (A12)
/A13: U2.3 (A0), U9.14 (A13)
/A14: U2.6 (A3), U9.10 (A14)
/A15: U2.10 (A7), U9.56 (A15)
/A_DIR: J1.9, U1.2 (DIR), U2.2 (DIR)
/A_OE: J1.40, U1.22 (~OE), U2.22 (~OE)
/BLUE: U6.5 (A2), U9.66 (BLUE)
/CAPS: U9.63 (CAPS), U10.3 (1Y)
/CAPSOUT: J3.5, U10.2 (1A)
/CASIN: R9.2, R10.1, U9.59 (CASIN), U11.3 (IN+)
/CASMO: U6.3 (A0), U9.64 (CASMO)
/CAS_OUT: U6.10 (A7), U9.50 (CAS_OUT)
/CAS_RC: U9.47 (CAS_RC)
/CLK_IN: U4.3 (A0), U9.49 (CLK_IN)
/CSYNC: U6.4 (A1), U9.65 (CSYNC)
/DIV13: U9.55 (DIV13)
/G1_OE: J2.10, U6.22 (~OE)
/G2_DIR: J2.7, U7.2 (DIR)
/G2_OE: J2.3, U7.22 (~OE)
/G3_OE: J1.6, U8.22 (~OE)
/G4_OE: J2.19, U4.22 (~OE)
/GND: C1.1, C2.2, C3.2, C4.2, C5.2, C6.2, C7.2, C8.2, C9.2, C10.2, C11.2, C12.2, C13.2, C14.2, J1.12, J1.30, J2.11, J2.29, J3.12, R6.1, R10.2, U1.11 (GND_2), U1.12 (GND), U1.13 (GND_3), U2.11 (GND_2), U2.12 (GND), U2.13 (GND_3), U3.11 (GND_2), U3.12 (GND), U3.13 (GND_3), U4.11 (GND_2), U4.12 (GND), U4.13 (GND_3), U5.2 (DIR), U5.11 (GND_2), U5.12 (GND), U5.13 (GND_3), U6.2 (DIR), U6.11 (GND_2), U6.12 (GND), U6.13 (GND_3), U7.11 (GND_2), U7.12 (GND), U7.13 (GND_3), U8.2 (DIR), U8.11 (GND_2), U8.12 (GND), U8.13 (GND_3), U9.51 (GND), U9.68 (GND), U10.1 (1~OE), U10.7 (GND), U10.9 (3A), U10.12 (4A), U11.5 (-VS)
/GREEN: U6.7 (A4), U9.4 (GREEN)
/KBD0: U4.10 (A7), U9.27 (KBD0)
/KBD1: U4.9 (A6), U9.28 (KBD1)
/KBD2: U4.8 (A5), U9.31 (KBD2)
/KBD3: U4.7 (A4), U9.32 (KBD3)
/LVA0: J1.25, U2.17 (B4)
/LVA1: J1.24, U2.16 (B5)
/LVA2: J1.26, U2.19 (B2)
/LVA3: J1.37, U1.19 (B2)
/LVA4: J1.34, U1.16 (B5)
/LVA5: J1.35, U1.17 (B4)
/LVA6: J1.33, U1.15 (B6)
/LVA7: J1.32, U1.14 (B7)
/LVA8: J1.23, U2.15 (B6)
/LVA9: J1.39, U1.21 (B0)
/LVA10: J1.38, U1.20 (B1)
/LVA11: J1.36, U1.18 (B3)
/LVA12: J1.27, U2.20 (B1)
/LVA13: J1.28, U2.21 (B0)
/LVA14: J1.31, U2.18 (B3)
/LVA15: J1.22, U2.14 (B7)
/LVBLUE: J2.13, U6.19 (B2)
/LVCASIN: J3.3, R8.1, U11.1 (OUT)
/LVCASMO: J2.9, U6.21 (B0)
/LVCAS_OUT: J2.20, U6.14 (B7)
/LVCLK_IN: J2.22, U4.21 (B0)
/LVCSYNC: J2.14, U6.20 (B1)
/LVGREEN: J2.15, U6.17 (B4)
/LVKBD0: J2.27, U4.14 (B7)
/LVKBD1: J2.28, U4.15 (B6)
/LVKBD2: J2.25, U4.16 (B5)
/LVKBD3: J2.26, U4.17 (B4)
/LVPD0: J2.31, U3.14 (B7)
/LVPD1: J2.40, U3.20 (B1)
/LVPD2: J2.34, U3.15 (B6)
/LVPD3: J2.33, U3.16 (B5)
/LVPD4: J2.38, U3.19 (B2)
/LVPD5: J2.35, U3.18 (B3)
/LVPD6: J2.36, U3.17 (B4)
/LVPD7: J2.37, U3.21 (B0)
/LVPHIOUT: J1.5, U8.21 (B0)
/LVRA0: J1.13, U5.21 (B0)
/LVRA1: J1.14, U5.20 (B1)
/LVRA2: J1.15, U5.19 (B2)
/LVRA3: J1.16, U5.18 (B3)
/LVRA4: J1.17, U5.17 (B4)
/LVRA5: J1.18, U5.16 (B5)
/LVRA6: J1.19, U5.15 (B6)
/LVRA7: J1.20, U5.14 (B7)
/LVRAM0: J2.4, U7.21 (B0)
/LVRAM1: J2.6, U7.20 (B1)
/LVRAM2: J2.5, U7.19 (B2)
/LVRAM3: J2.8, U7.18 (B3)
/LVRED: J2.18, U6.16 (B5)
/LVROM: J1.4, U8.20 (B1)
/LVRnWIN: J3.6, U4.19 (B2)
/LVRnWOUT: J1.7, U10.5 (2A)
/LVRnWnOE: J3.8, R4.2, U10.4 (2~OE)
/LVSND: J2.17, U6.15 (B6)
/LVnCAS: J1.3, U8.19 (B2)
/LVnHS: J2.16, U6.18 (B3)
/LVnIRQIN: J3.7, U4.20 (B1)
/LVnIRQOUT: J3.10, R3.2, U10.10 (3~OE)
/LVnNMI: J2.23, U4.18 (B3)
/LVnRAS: J1.2, U8.18 (B3)
/LVnWE: J1.1, U8.17 (B4)
/PD0: U3.10 (A7), U9.33 (PD0)
/PD1: U3.4 (A1), U9.35 (PD1)
/PD2: U3.9 (A6), U9.36 (PD2)
/PD3: U3.8 (A5), U9.38 (PD3)
/PD4: U3.5 (A2), U9.39 (PD4)
/PD5: U3.6 (A3), U9.41 (PD5)
/PD6: U3.7 (A4), U9.42 (PD6)
/PD7: U3.3 (A0), U9.45 (PD7)
/PD_DIR: J2.32, U3.2 (DIR)
/PD_OE: J2.39, U3.22 (~OE)
/PHIOUT: C2.1, R1.2, U9.60 (PHIOUT)
/RA0: U5.3 (A0), U9.22 (RA0)
/RA1: U5.4 (A1), U9.19 (RA1)
/RA2: U5.5 (A2), U9.18 (RA2)
/RA3: U5.6 (A3), U9.16 (RA3)
/RA4: U5.7 (A4), U9.11 (RA4)
/RA5: U5.8 (A5), U9.8 (RA5)
/RA6: U5.9 (A6), U9.7 (RA6)
/RA7: U5.10 (A7), U9.6 (RA7)
/RAM0: U7.3 (A0), U9.34 (RAM0)
/RAM1: U7.4 (A1), U9.37 (RAM1)
/RAM2: U7.5 (A2), U9.40 (RAM2)
/RAM3: U7.6 (A3), U9.44 (RAM3)
/RA_OE: J1.10, U5.22 (~OE)
/RED: U6.8 (A5), U9.3 (RED)
/RESET: D1.1 (K), U9.58 (RESET), U10.11 (4Y)
/RESETIN: D1.2 (A), J2.1, R5.2
/RESETOUT: J2.2, R2.2, U10.13 (4~OE)
/ROM: U8.4 (A1), U9.61 (ROM)
/RnW: U4.5 (A2), U9.46 (RnW), U10.6 (2Y)
/SND: U6.9 (A6), U9.62 (SND)
/nCAS: U8.5 (A2), U9.53 (nCAS)
/nHS: U6.6 (A3), U9.67 (nHS)
/nIRQ: R11.1, U4.4 (A1), U9.30 (nIRQ), U10.8 (3Y)
/nNMI: U4.6 (A3), U9.57 (nNMI)
/nPOR: U9.54 (nPOR)
/nRAS: U8.6 (A3), U9.52 (nRAS)
/nWE: U8.7 (A4), U9.29 (nWE)
unnamed: R1.1, U8.3 (A0)
unnamed: R6.2, R7.1, U11.4 (IN-)

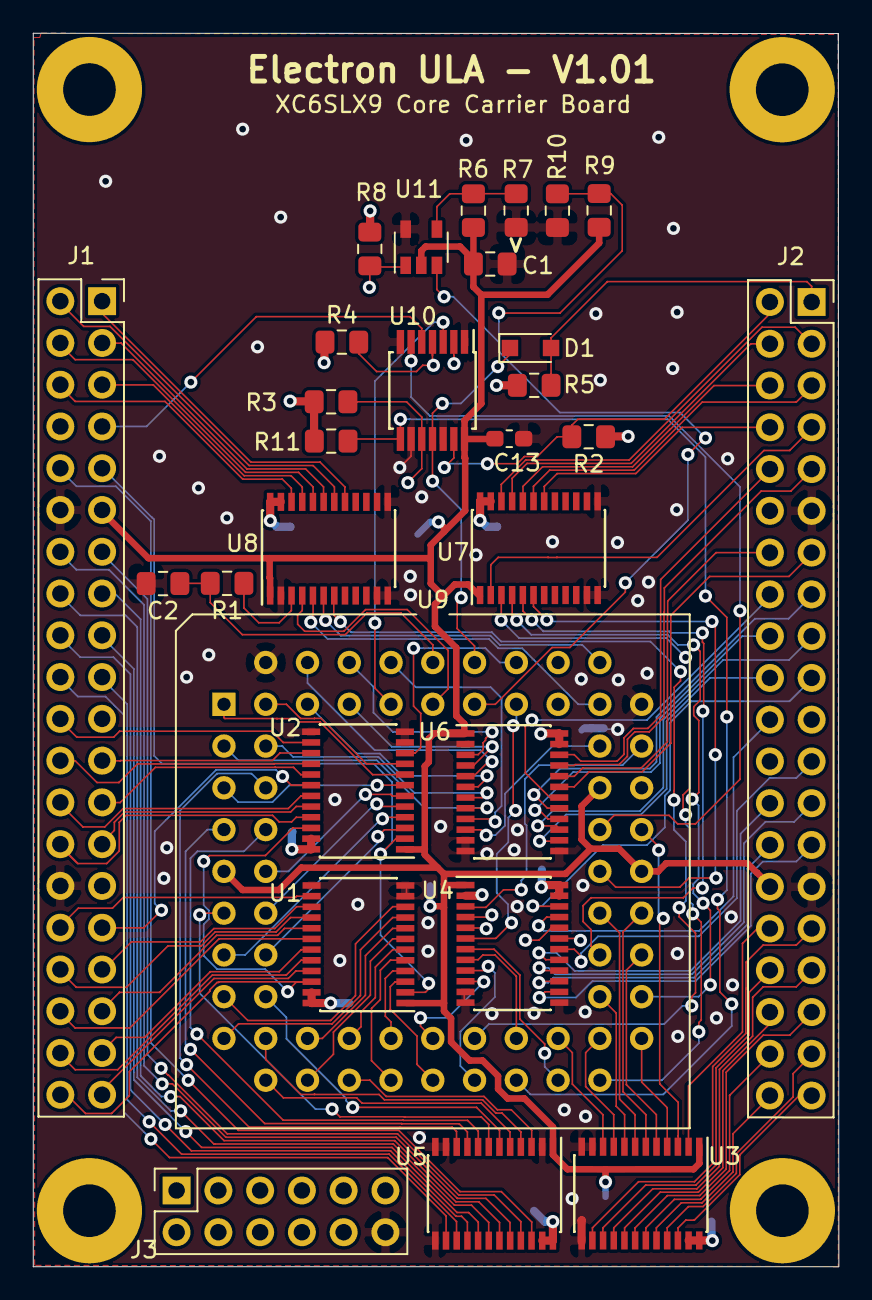
[picture p8: board Kicad/ElectronULA - Core Carrier Board/ElectronULA.kicad_pcb from above]

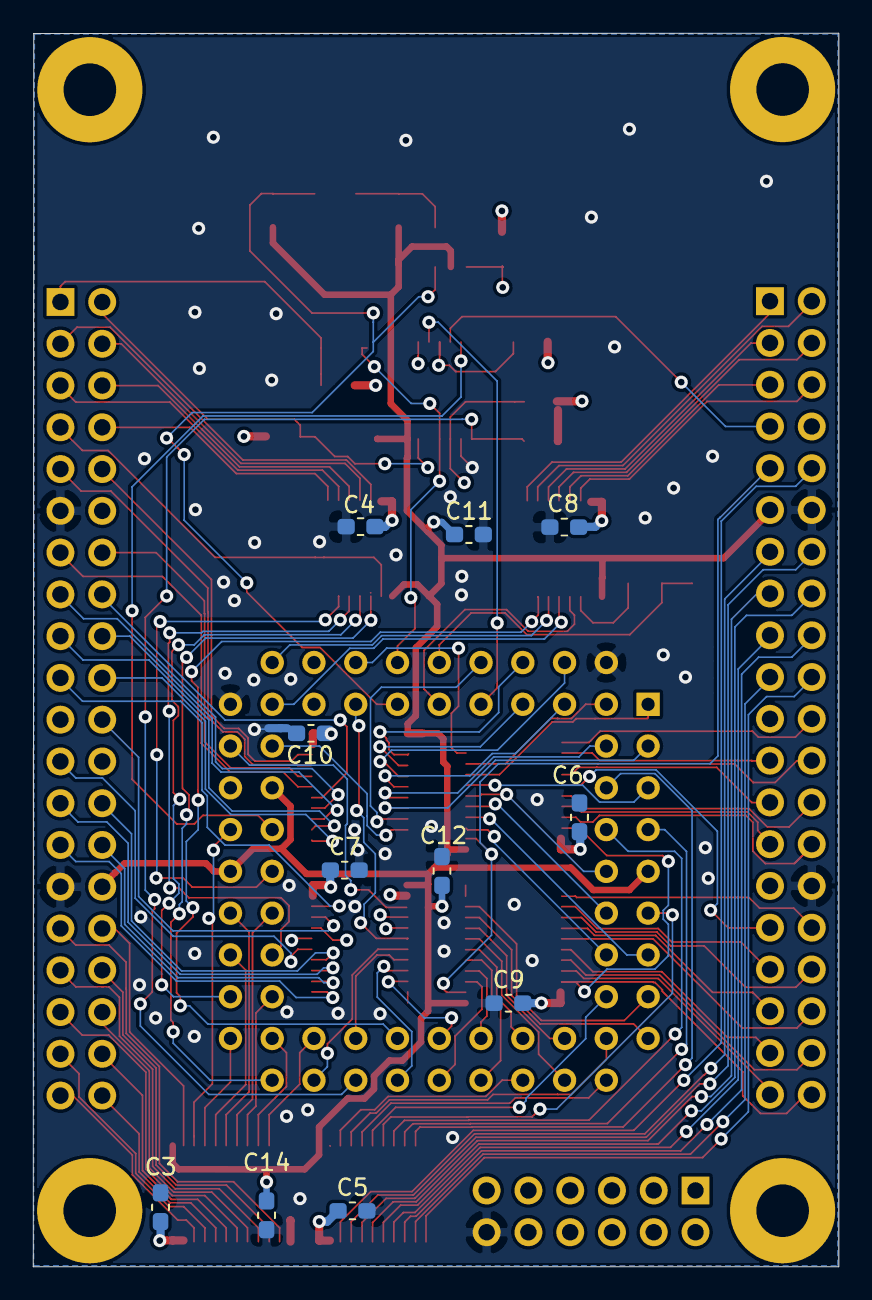
[picture p9: board Kicad/ElectronULA - Core Carrier Board/ElectronULA.kicad_pcb from below]

Board: 4 copper layers, 49.0 x 75.0 mm, 44 parts (11 on the bottom side), 139 nets.

Other parts of the board:
H2, H2#2, H2#3, H2#4: MountingHole_Pad; MountingHole_3.2mm_M3_Pad
