EquasysIT/ElectronULA/VHDL/MAX 10 Board/ULA_UFM/ULA_UFM_inst.vhd

	component ULA_UFM is
		port (
			clock                   : in  std_logic                     := 'X';             -- clk
			avmm_data_addr          : in  std_logic_vector(15 downto 0) := (others => 'X'); -- address
			avmm_data_read          : in  std_logic                     := 'X';             -- read
			avmm_data_readdata      : out std_logic_vector(31 downto 0);                    -- readdata
			avmm_data_waitrequest   : out std_logic;                                        -- waitrequest
			avmm_data_readdatavalid : out std_logic;                                        -- readdatavalid
			avmm_data_burstcount    : in  std_logic_vector(1 downto 0)  := (others => 'X'); -- burstcount
			reset_n                 : in  std_logic                     := 'X'              -- reset_n
		);
	end component ULA_UFM;

	u0 : component ULA_UFM
		port map (
			clock                   => CONNECTED_TO_clock,                   --    clk.clk
			avmm_data_addr          => CONNECTED_TO_avmm_data_addr,          --   data.address
			avmm_data_read          => CONNECTED_TO_avmm_data_read,          --       .read
			avmm_data_readdata      => CONNECTED_TO_avmm_data_readdata,      --       .readdata
			avmm_data_waitrequest   => CONNECTED_TO_avmm_data_waitrequest,   --       .waitrequest
			avmm_data_readdatavalid => CONNECTED_TO_avmm_data_readdatavalid, --       .readdatavalid
			avmm_data_burstcount    => CONNECTED_TO_avmm_data_burstcount,    --       .burstcount
			reset_n                 => CONNECTED_TO_reset_n                  -- nreset.reset_n
		);
