EquasysIT/ElectronULA/(commit log)

2020-06-03 Added "All in one MAX 10" board
    [BOM.xlsx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]
2020-06-19 Added latest ver 1.02 board
    [BOM.xlsx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]
2020-06-20 Updated BOM
    [BOM.xlsx]
2020-06-25 Updated BOM to provide technique for soldering the MAX 10 FPGA
    [BOM.xlsx]
2020-06-26 Added 4.7K pullups for the keyboard Inputs
    [BOM.xlsx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]
2020-06-26 Cleared Gerbers
    [ElectronULA-B_Cu.gbr, ElectronULA-B_Mask.gbr, ElectronULA-B_SilkS.gbr, ElectronULA-Edge_Cuts.gbr, ElectronULA-F_Cu.gbr, ElectronULA-F_Mask.gbr, ElectronULA-F_SilkS.gbr, ElectronULA-In1_Cu.gbr]
2020-06-29 Update .qsf file to include Switch connections
2020-07-05 Fix for UFM SAA5050 Char ROM Initialisation
    [ElectronULA.vhd]
2020-07-28 Updated with changes from Hoglet
    Fix for 0xC0DE's vertical rupture test (a6ce79a) and transparent latch fix (af6c24e)
    [ElectronULA.qsf, ElectronULACore.vhd]
2020-08-21 Added controlling of CPU Speed & Interlacing via switches
2021-01-30 Added latest V1.03 Gerbers
    [ElectronULA-B_Cu.gbr, ElectronULA-B_Mask.gbr, ElectronULA-B_SilkS.gbr, ElectronULA-Edge_Cuts.gbr, ElectronULA-F_Cu.gbr, ElectronULA-F_Mask.gbr, ElectronULA-F_SilkS.gbr, ElectronULA-In1_Cu.gbr]
2022-03-15 Added version 1.04 of PCB
    [BOM.xlsx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]
2023-01-16 Update ElectronULA.vhd
    Changes to fix bus contention issues
    [ElectronULA.vhd]
2023-01-17 Fix databus contention issues
    Updated buffer control to fix databus contention issues
    [ElectronULA.vhd]
2023-07-07 Updated with latest VHDL and Kicad Ver 1.05 Board
    [BOM.xlsx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]
2023-07-12 Latest version 1.05 with keyboard glitch fix
    [BOM.xlsx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]
2023-07-14 Update to latest FPGA pof file
    [BOM.xlsx]
2023-07-15 Update Gerbers
    [ElectronULA-B_Cu.gbl, ElectronULA-B_Mask.gbs, ElectronULA-B_Paste.gbp, ElectronULA-B_Silkscreen.gbo, ElectronULA-Edge_Cuts.gm1, ElectronULA-F_Cu.gtl, ElectronULA-F_Mask.gts, ElectronULA-F_Paste.gtp]
2025-09-27 Added files to enable direct compiling in Quartus
    [ULA_UFM.csv]
