EquasysIT/ElectronULA/(notices)

Notices in the files:
Kicad/ElectronULA - MAX 10 Board V1.05/ElectronULA.kicad_pcb:
(C) 2023 Andy Burgess
